HexabitzPlatform/H19R0x-Hardware/README.md

# H19R0x-Hardware
Hexabitz 38 V/10A Sensored BLDC Module Hardware Design
