HexabitzPlatform/H19R0x-Hardware/H19R00/Released/BOM/H19R00.xlsx

 |  | www.hexabitz.com info@hexabitz.com |  | Bill Of Materials
Customer | Hexabitz | Revision | 0
Project | Hexabitz Modules | Date | 2023-10-30
Board | 38 V/10A Sensored BLDC (H19R0) | Notes
Designator | Description | Manufacturer Part Number | Manufacturer | Octopart Url | Quantity
R | Headers & Wire Housings Unshrouded 1 POS T/H | 5-146280-1 | TE Connectivity | https://octopart.com/5-146280-1-te+connectivity+%2F+amp-40259676?r=sp | 1
SWD | Conn Unshrouded Header HDR 3 POS 2.54mm Solder ST Top Entry Thru-Hole Carton | 5-146281-3 | TE Connectivity | https://octopart.com/5-146281-3-te+connectivity+%2F+amp-39745942?r=sp | 1
J2 | TERM BLK 2POS SIDE ENTRY 5MM PCB | 691213710002 | Würth Elektronik | https://octopart.com/691213710002-wurth+elektronik-8917718?r=sp | 1
J1 | TERM BLK 3POS SIDE ENTRY 5MM PCB | 691213710003 | Wurth Elektronik | https://octopart.com/691213710003-wurth+elektronik-8917719?r=sp | 1
J4 | CONN HEADER SMD 6POS 1.27MM | 20021121-00006C1LF | Amphenol | https://octopart.com/20021121-00006c1lf-amphenol+communications+solutions-126547105?r=sp | 1
J3 | CONN HEADER SMD 8POS 1.27MM | 20021121-00008T4LF | Amphenol | https://octopart.com/20021121-00008t4lf-amphenol+communications+solutions-126517168?r=sp | 1
R1 , R52 | RES SMD 0.0OHM JUMPER 1/10W 0603 | RC0603JR-070RL | Yageo | https://octopart.com/rc0603jr-070rl-yageo-1241539?r=sp | 2
R10, R14, R17 | Current Sense Resistors - SMD 50 mOhms 1 W 50PPM/C 1 % 1206 | PE1206FRE470R05L | Yageo | https://octopart.com/pe1206fre470r05l-yageo-116359628?r=sp | 3
R4, R5, R11, R13, R15, R16 | RES 100 OHM 1% 1/10W 0603 | AC0603FR-13100RL | Yageo | https://octopart.com/ac0603fr-13100rl-yageo-74169481?r=sp | 6
R2, R53 | Thick Film Resistors - SMD 0603 270 Ohm 5% Tol | ERJ-3GEYJ271V | Panasonic | https://octopart.com/erj-3geyj271v-panasonic-55560546?r=sp | 2
R46, R48, R49 | Thick Film Resistors - SMD 0603 0.25W 1% 510ohm AEC-Q200 | ERJ-UP3F5100V | Panasonic | https://octopart.com/erj-up3f5100v-panasonic-108179035?r=sp | 3
R26, R28, R56 | RES 1K OHM 1% 1/10W 0603 | AC0603FR-131KL | Yageo | https://octopart.com/ac0603fr-131kl-yageo-73876229?r=sp | 3
R8, R18, R20, R40, R43, R45 | RES 2.4K OHM 1% 1/10W 0603 | RC0603FR-132K4L | Yageo | https://octopart.com/rc0603fr-132k4l-yageo-9297431?r=sp | 6
R9, R42, R44 | SMD Chip Resistor, 7.15 kOhm, ± 1%, 100 mW, 0603 | ERJ-3EKF7151V | Panasonic | https://octopart.com/erj-3ekf7151v-panasonic-55403668?r=sp | 3
R3, R55 | RES 10K Ohm 1% 0603 | RC0603FR-0710KL | Yageo | https://octopart.com/rc0603fr-0710kl-yageo-40025538?r=sp | 2
R24, R27, R29, R57 | RES 12K OHM 1% 1/10W 0603 | RC0603FR-0712KL | Yageo | https://octopart.com/rc0603fr-0712kl-yageo-55402881?r=sp | 4
R6, R7, R19, R21, R22, R41 | SMD Chip Resistor, 14.3 kOhm, ± 1%, 100 mW | ERJ-3EKF1432V | Panasonic | https://octopart.com/erj-3ekf1432v-panasonic-55421474?r=sp | 6
R25 | RES 100K OHM 1% 1/10W 0603 | RC0603FR-07100KL | Yageo | https://octopart.com/rc0603fr-07100kl-yageo-40946036?r=sp | 1
R54 | RES 180K OHM 1% 1/10W 0603 | RC0603FR-07180KL | Yageo | https://octopart.com/rc0603fr-07180kl-yageo-40952833?r=sp | 1
R47 | 200 kOhms ±1% 0.1W, 1/10W Chip Resistor 0603 | RC0603FR-07200KL | YAGEO | https://octopart.com/rc0603fr-07200kl-yageo-1190520?r=sp | 1
R12 | RES 750K OHM 1% 1/10W 0603 | RC0603FR-07750KL | Yageo | https://octopart.com/rc0603fr-07750kl-yageo-1227954?r=sp | 1
R23 | RES 2.4M OHM 1% 1/10W 0603 | RC0603FR-072M4L | Yageo | https://octopart.com/rc0603fr-072m4l-yageo-16255653?r=sp | 1
C14, C17, C18 | CAP CER 33PF 50V C0G/NP0 0603 | 0603N330J500CT | Walsin Technology Corporation | https://octopart.com/0603n330j500ct-walsin+technologies-23759704?r=sp | 3
C28, C29, C46 | CAP CER 220PF 50V X7R 0603 | 0603B221K500CT | Walsin Technology Corporation | https://octopart.com/0603b221k500ct-walsin+technologies-44320887?r=sp | 3
C19, C26, C27 | CAP CER 1000PF 50V C0G/NPO 0603 | CC0603KRNPO9BN102 | YAGEO | https://octopart.com/cc0603krnpo9bn102-yageo-65850404?r=sp | 3
C45 | CAP CER 0603 2.2NF 16V X7R 10% | C0603C222K4RECAUTO | KEMET | https://octopart.com/c0603c222k4recauto-kemet-91526488?r=sp | 1
C32, C33 | CAP CER 0603 10nF 100V X7R | C0603X103K1RAC3316 | KEMET | https://octopart.com/c0603x103k1rac3316-kemet-75810806?r=sp | 2
C1 ,C2, C4, C6, C21, C22, C23 | CAP CER 0.1 UF 10V 10% X7R 0603 | C0603C104K8RACTU | KEMET | https://octopart.com/c0603c104k8ractu-kemet-145075?r=sp | 7
C11, C15, C16 | CAP CER 0805 150NF 100V X7R | 08051C154KAT2A | KYOCERA AVX | https://octopart.com/08051c154kat2a-kyocera+avx-122049659?r=sp | 3
C8, C9, C10 | CAP CER 470nF 50V X5R 0603 | C1608X5R1H474K080AB | TDK Corporation | https://octopart.com/c1608x5r1h474k080ab-tdk-26013511?r=sp | 3
C5 | CAP CER 1 UF 16V X7R 0805 | CC0805KKX7R7BB105 | YAGEO | https://octopart.com/cc0805kkx7r7bb105-yageo-8376555?r=sp | 1
C24, C25 | CAP CER 1UF 50V X5R 0603 | UMK107BJ105KA-T | Taiyo Yuden | https://octopart.com/umk107bj105ka-t-taiyo+yuden-12090744?r=sp | 2
C7, C3 | CAP TANT 4.7 UF 10V 20% 0805 | 10TPU4R7MSI | Panasonic | https://octopart.com/10tpu4r7msi-panasonic-29487748?r=sp | 2
C12, C13 | CAP CER 10UF 50V X5R 0805 | GRM21BR61H106KE43K | Murata Electronics | https://octopart.com/grm21br61h106ke43k-murata-106705599?r=sp | 2
C20 | CAP CER 47UF 10V X5R 0805 | GRM21BR61A476ME15L | Murata Electronics | https://octopart.com/grm21br61a476me15l-murata-46693541?r=sp | 1
C30, C31 | Aluminum Electrolytic Capacitors - Radial Leaded 100uF 50V 85c | UVR1H101MPD1TD | Nichicon | https://octopart.com/uvr1h101mpd1td-nichicon-9292643?r=sp | 2
FB1 | Ind chip Bead Multi-Layer 30 ohms 25% 100MHZ Ferrite 1,5A 0603Punched paper T/R | MMZ1608Y300BTA00 | TDK | https://octopart.com/mmz1608y300bta00-tdk-7906990?r=sp | 1
FB2 | FIXED IND 22UH 220MA 1.25OHM SMD | MLZ2012P220WT000 | TDK Corporation | https://octopart.com/mlz2012p220wt000-tdk-34829284?r=sp | 1
D1, D10 | Red 0603 130° Clear 54 mcd 2 V Surface Mount ChipLED | VLMS1300-GS08 | Vishay | https://octopart.com/vlms1300-gs08-vishay-21709201?r=sp | 2
D2, D3, D4, D5, D6, D7 | Diode 30 V 300mA Surface Mount SOD-523 | BAT30KFILM | STMicroelectronics | https://octopart.com/bat30kfilm-stmicroelectronics-658191?r=sp | 6
D8 | Diode 100 V 200mA Surface Mount SOD-123 | MMSD4448 | onsemi | https://octopart.com/mmsd4448-onsemi-84330297?r=sp | 1
Q1, Q2, Q3 | 60V DUAL N-CHANNEL ENHANCEMENT M | PJQ5866A_R2_00001 | Panjit International Inc. | https://octopart.com/search?q=PJQ5866A_R2_00001&currency=USD&specs=0 | 3
U1 | MCU 32-Bit ARM Cortex-M0+ RISC 512kByte Flash 1.7V to 3.6V 48-Pin UFQFPN Tray | STM32G0B1CEU6N | STMicroelectronics | https://octopart.com/stm32g0b1ceu6n-stmicroelectronics-116364672?r=sp | 1
U2 | Advanced BLDC controller with embedded STM32 MCU | STSPIN32F0A | STMicroelectronics | https://octopart.com/stspin32f0a-stmicroelectronics-87213744?r=sp | 1
U3 | RS422RS485 interface transceiver 0/4 16VQFN | AM26LV32EIRGYR | Texas Instruments | https://octopart.com/am26lv32eirgyr-texas+instruments-12191980?r=sp | 1
U4 | LDO Regulator, 150 mA, 38 V, 1 uA IQ, with PG ADJ HZ, WDFN6 2x2 | NCP730BMTADJTBG | On Semi | https://octopart.com/ncp730bmtadjtbg-onsemi-106608704?r=sp | 1
X1 | 8,0000MHZ 33pF SMD MURATA Resonators | CSTNE8M00G550000R0 | Murata | https://octopart.com/cstne8m00g550000r0-murata-91406934?r=sp | 1
