HexabitzPlatform/H19R0x-Hardware/H19R00/Documentation/H19R00.pdf

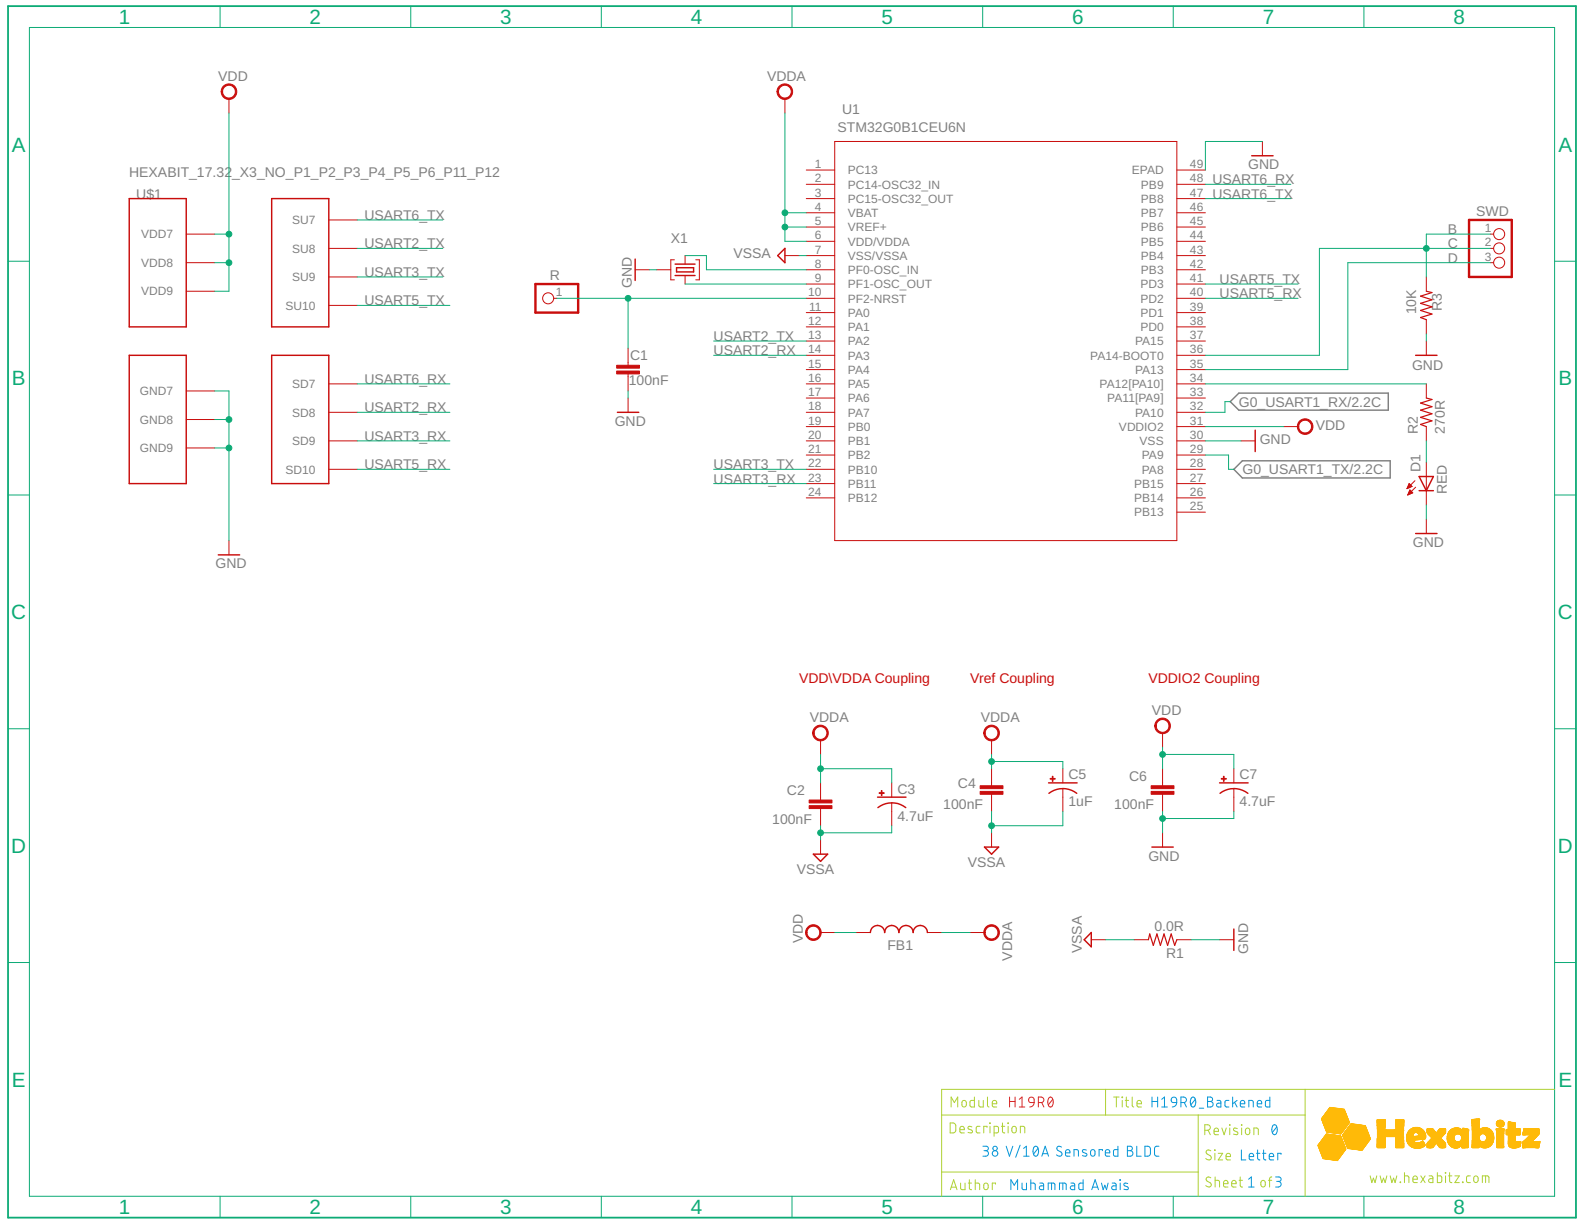
[picture p1: page 1]

VDDA

5 | | 45 PB7
6 | | 44 PB6

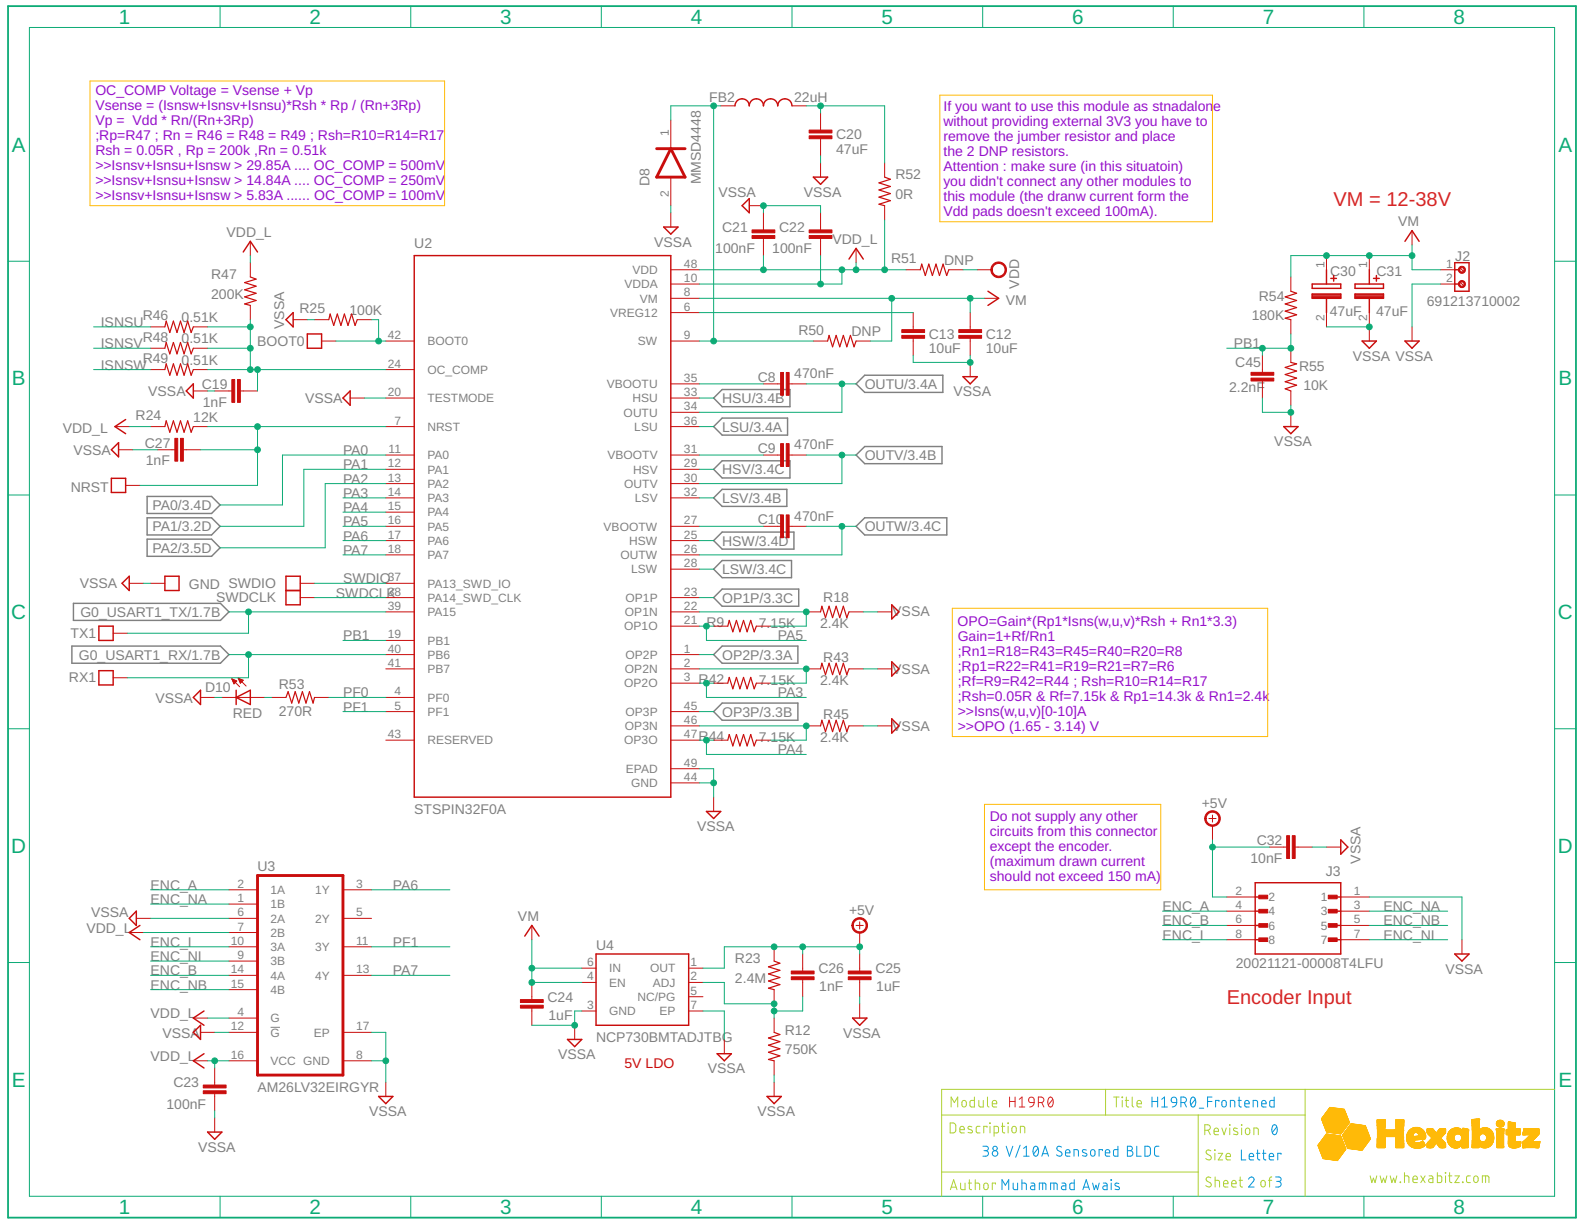
[picture p2: page 2]

OC_COMP Voltage = Vsense + Vp
Vsense = (Isnsw+Isnsv+Isnsu)*Rsh * Rp / (Rn+3Rp)
Vp = Vdd * Rn/(Rn+3Rp)
;Rp=R47 ; Rn = R46 = R48 = R49 ; Rsh=R10=R14=R17
Rsh = 0.05R , Rp = 200k ,Rn = 0.51k >>Isnsv+Isnsu+Isnsw > 29.85A .... OC_COMP = 500mV

If you want to use this module as stnadalone without providing external 3V3 you have to

remove the jumber resistor and place
the 2 DNP resistors. Attention : make sure (in this situatoin)

you didn't connect any other modules to
this module (the dranw current form the Vdd pads doesn't exceed 100mA).

8 VREG12

DNP

PA0 | 34 OUTV

PA2 | 31 VBOOTW
12 PA1 | HSV/3.4C

PA3 | 29 HSW 32

Do not supply any other circuits from this connector except the encoder. (maximum drawn current should not exceed 150 mA)

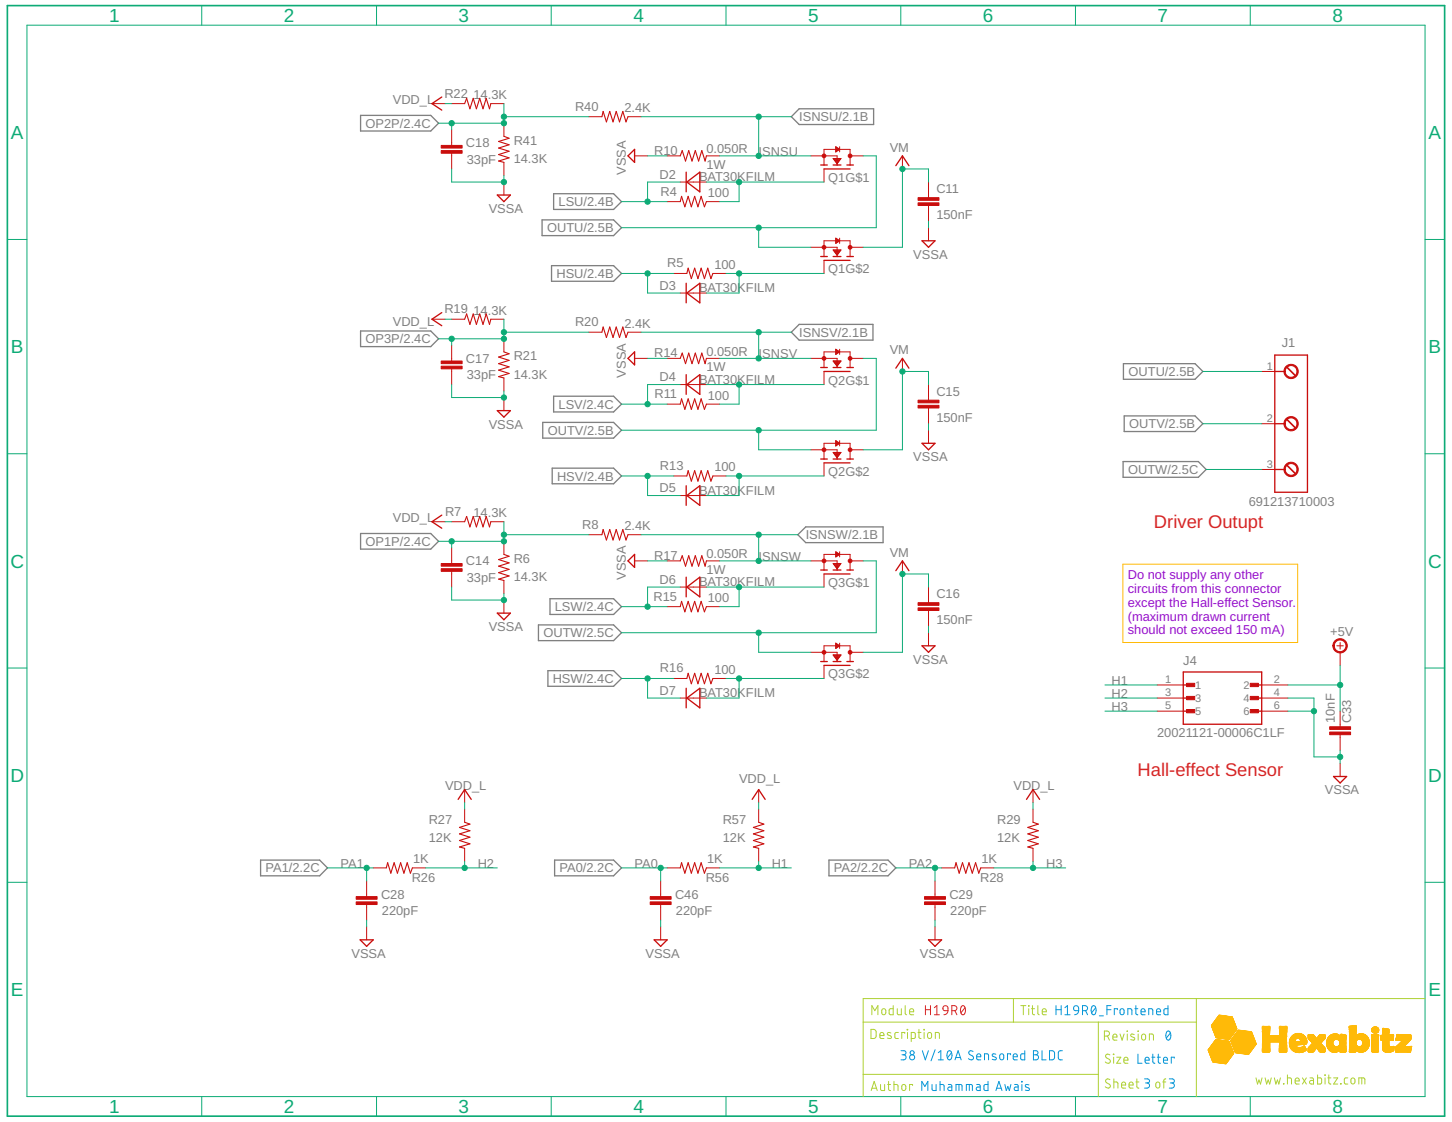
[picture p3: page 3]

Do not supply any other circuits from this connector except the Hall-effect Sensor. (maximum drawn current should not exceed 150 mA)
