HexabitzPlatform/H19R0x-Hardware/H19R00/Design/H19R00.brd

## EAGLE design H19R00/Design/H19R00.brd (2023-11-10)

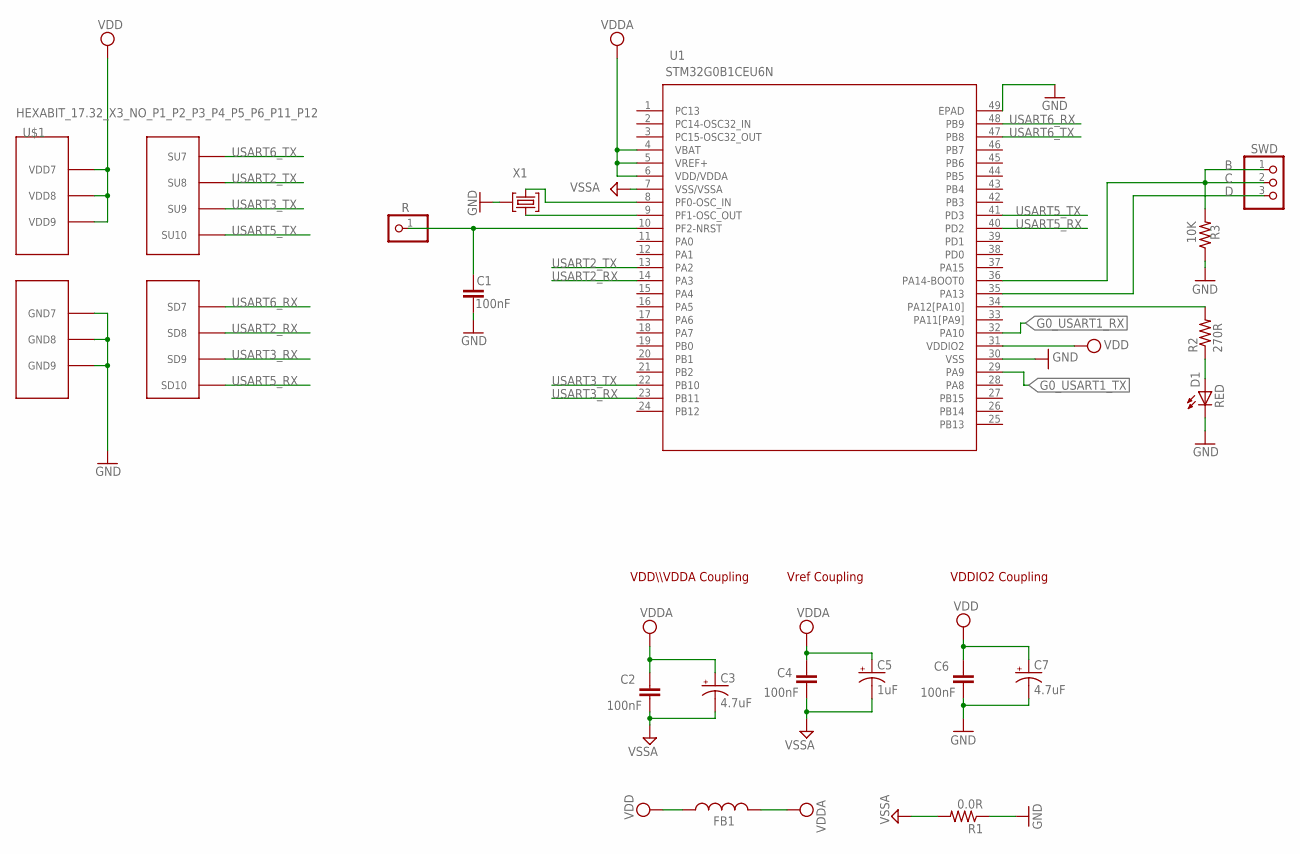
[picture p4: schematic H19R00.sch, sheet 1, I/O parts]

Parts:
C1: 100nF; C-0603; TOLERANCE 10%; VOLTAGE_RATING 16.0 V; MPN 0603YC104K4T2A
C2, C4, C6: 100nF; C-0603; TOLERANCE 10%; VOLTAGE_RATING 16.0 V; MPN '0603YC104K4T2A
C3: 4.7uF; C-0805-POL; TOLERANCE 20%; VOLTAGE_RATING 10.0 V; MPN '10TPU4R7MSI
C5: 1uF; C-0805-POL; TOLERANCE 20%; VOLTAGE_RATING 10.0 V; MPN 'CC0805KKX7R7BB105
C7: 4.7uF; C-0805-POL; TOLERANCE 10%; VOLTAGE_RATING 16.0 V; MPN '10TPU4R7MSI
D1: RED; VLMS1300-GS08
FB1: FB-TDK_MMZ1608Y300B; MPN MMZ1608Y300BTA00
R: PINHD-1X1; 1X01
R1: 0.0R; R-0603; MPN RC0603JR-070RL
R2: 270R; R-0603; MPN 'ERJ-3GEYJ271V
R3: 10K; R-0603; MPN '060300J0103T5E
SWD: PINHD-1X3; 1X03
U1: STM32G0B1CEU6N; HEXABITZ_ICS_QFN_B1CEU6_STM-L
U$1: HEXABIT_17.32_X3_NO_P1_P2_P3_P4_P5_P6_P11_P12
X1: 8MHZ; XTALL_CSTCE8M00G52; MPN CSTNE8M00G550000R0

Connections:
C: R3.2, SWD.1, SWD.2, U1.36 (PA14-BOOT0)
D: SWD.3, U1.35 (PA13)
G0_USART1_RX: U1.32 (PA10); also elsewhere on the board
G0_USART1_TX: U1.29 (PA9); also elsewhere on the board
GND: C1.1, C6.1, C7.2 (-), D1.C, R1.1, R3.1, U1.30 (VSS), U1.49 (EPAD), U$1.PAD_PD12 (GND7), U$1.PAD_PD17 (GND8), U$1.PAD_PD19 (GND9), X1.P$2 (2)
GND1: C2.1, C3.2 (-), C4.1, C5.2 (-), R1.2, U1.7 (VSS/VSSA); also elsewhere on the board
unnamed: U1.8 (PF0-OSC_IN), X1.P$1 (1)
unnamed: U1.9 (PF1-OSC_OUT), X1.P$3 (3)
unnamed: R2.2, U1.34 (PA12[PA10])
unnamed: D1.A, R2.1
unnamed: C1.2, R.1, U1.10 (PF2-NRST)
USART2_RX: U1.14 (PA3), U$1.PAD_PD1 (SD8)
USART2_TX: U1.13 (PA2), U$1.PAD_PU1 (SU8)
USART3_RX: U1.23 (PB11), U$1.PAD_PD2 (SD9)
USART3_TX: U1.22 (PB10), U$1.PAD_PU2 (SU9)
USART5_RX: U1.40 (PD2), U$1.PAD_PD8 (SD10)
USART5_TX: U1.41 (PD3), U$1.PAD_PU8 (SU10)
USART6_RX: U1.48 (PB9), U$1.PAD_PD3 (SD7)
USART6_TX: U1.47 (PB8), U$1.PAD_PU3 (SU7)
VDD: C6.2, C7.1 (+), FB1.1, U1.31 (VDDIO2), U$1.PAD_PU12 (VDD7), U$1.PAD_PU17 (VDD8), U$1.PAD_PU19 (VDD9); also elsewhere on the board
VDDA: C2.2, C3.1 (+), C4.2, C5.1 (+), FB1.2, U1.4 (VBAT), U1.5 (VREF+), U1.6 (VDD/VDDA)

Notes on the sheet:
VDDIO2 Coupling
VDD\\\VDDA Coupling
Vref Coupling

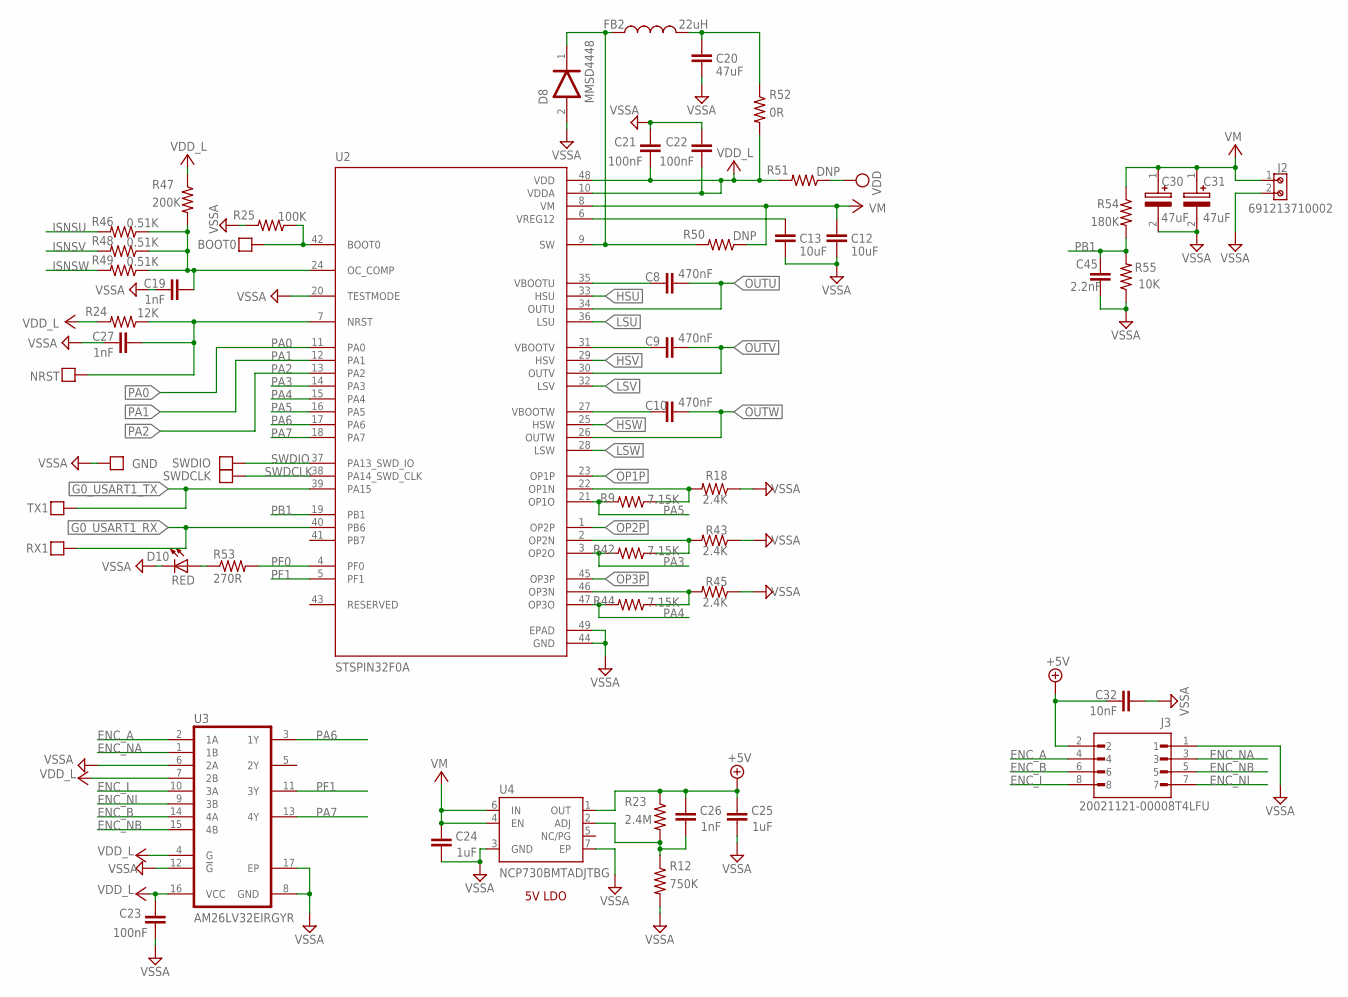
[picture p5: schematic H19R00.sch, sheet 2]

Parts:
BOOT0: PAD4
C8, C9, C10: 470nF; C-0603; TOLERANCE 10%; VOLTAGE_RATING 50V; MPN C1608X5R1H474K080AB
C12, C13: 10uF; C-0805; TOLERANCE 10%; VOLTAGE_RATING 50V; MPN GRM21BR61H106KE43K
C19, C26, C27: 1nF; C-0603; TOLERANCE 10%; VOLTAGE_RATING 50V; MPN CC0603KRNPO9BN102
C20: 47uF; C-0805; TOLERANCE 20%; VOLTAGE_RATING 10V; MPN GRM21BR61A476ME15K
C21, C22, C23: 100nF; C-0603; TOLERANCE 10%; VOLTAGE_RATING 16.0 V; MPN '0603YC104K4T2A
C24, C25: 1uF; C-0603; TOLERANCE 10%; VOLTAGE_RATING 50V; MPN UMK107BJ105KA-T
C30, C31: 47uF; CAPPRD350W60D825H1300
C32: 10nF; C-0603; TOLERANCE 10%; VOLTAGE_RATING 100V; MPN C0603X103K1RAC3316
C45: 2.2nF; C-0603; TOLERANCE 10%; VOLTAGE_RATING 16V; MPN C0603C222K4RECAUTO
D8: MMSD4448ONSEMI_MMSD4448_0_0; ONSEMI_MMSD4448_0
D10: RED; VLMS1300-GS08
FB2: 22uH; FB-0805; MPN MLZ2012P220WT000
GND: PAD4
J2: 691213710002
J3: 20021121-00008T4LFU; AMPHENOL_20021121-00008T4LF
NRST: PAD4
R9, R42, R44: 7.15K; R-0603; TOLERANCE 1%; MPN RC0603FR-0710K5L
R12: 750K; R-0603; TOLERANCE 1%; MPN RC0603FR-07750KL
R18, R43, R45: 2.4K; R-0603; TOLERANCE 1%; MPN RC0603FR-132K4L
R23: 2.4M; R-0603; TOLERANCE 1%; MPN RC0603FR-072M4L
R24: 12K; R-0603; TOLERANCE 1%; MPN RC0603FR-0712KL
R25: 100K; R-0603; TOLERANCE 1%; MPN RC0603FR-07100KL
R46, R48, R49: 0.51K; R-0603; TOLERANCE 1%; MPN RC0603FR-102K2L
R47: 200K; R-0603; TOLERANCE 1%; MPN RC0603FR-0718KL
R50, R51: DNP; R-0603; MPN DNP
R52: 0R; R-0603; TOLERANCE 1%; MPN RC0603FR-070RL
R53: 270R; R-0603; MPN 'ERJ-3GEYJ271V
R54: 180K; R-0603; TOLERANCE 1%; MPN RC0603FR-07180KL
R55: 10K; R-0603; MPN '060300J0103T5E
RX1: PAD4
SWDCLK: PAD4
SWDIO: PAD4
TX1: PAD4
U2: STSPIN32F0A; IC_STSPIN32F0A
U3: AM26LV32EIRGYRTEXAS_INSTRUMENTS_AM26LV32EIRGYR_0_0; TEXAS_INSTRUMENTS_AM26LV32EIRGYR_0
U4: NCP730BMTADJTBGON_SEMI_NCP730BMTADJTBG_0_0; ON_SEMI_NCP730BMTADJTBG_0

Connections:
+5V: C25.2, C26.2, C32.1, J3.2, R23.1, U4.1 (OUT); also elsewhere on the board
ENC_A: J3.4, U3.2 (1A)
ENC_B: J3.6, U3.14 (4A)
ENC_I: J3.8, U3.10 (3A)
ENC_NA: J3.3, U3.1 (1B)
ENC_NB: J3.5, U3.15 (4B)
ENC_NI: J3.7, U3.9 (3B)
G0_USART1_RX: RX1.P$1, U2.40 (PB6); also elsewhere on the board
G0_USART1_TX: TX1.P$1, U2.39 (PA15); also elsewhere on the board
GND1: C12.2, C13.2, C19.1, C20.2, C21.2, C22.2, C23.1, C24.1, C25.1, C27.1, C30.2 (-), C31.2 (-), C32.2, C45.1, D8.2 (ANODE), D10.C, GND.P$1, J2.2, J3.1, R12.2, R18.1, R25.2, R43.1, R45.1, R55.1, U2.20 (TESTMODE), U2.44 (GND), U2.49 (EPAD), U3.8 (GND), U3.12 (!G!), U3.17 (EP), U4.3 (GND), U4.7 (EP); also elsewhere on the board
HSU: U2.33 (HSU); also elsewhere on the board
HSV: U2.29 (HSV); also elsewhere on the board
HSW: U2.25 (HSW); also elsewhere on the board
ISNSU: R46.2; also elsewhere on the board
ISNSV: R48.2; also elsewhere on the board
ISNSW: R49.2; also elsewhere on the board
LSU: U2.36 (LSU); also elsewhere on the board
LSV: U2.32 (LSV); also elsewhere on the board
LSW: U2.28 (LSW); also elsewhere on the board
unnamed: R42.1, R43.2, U2.2 (OP2N)
unnamed: C8.2, U2.35 (VBOOTU)
unnamed: C9.2, U2.31 (VBOOTV)
unnamed: C10.2, U2.27 (VBOOTW)
unnamed: C26.1, R12.1, R23.2, U4.2 (ADJ)
unnamed: C27.2, NRST.P$1, R24.1, U2.7 (NRST)
unnamed: C13.1, U2.6 (VREG12)
unnamed: BOOT0.P$1, R25.1, U2.42 (BOOT0)
unnamed: R9.1, R18.2, U2.22 (OP1N)
unnamed: R44.1, R45.2, U2.46 (OP3N)
unnamed: C19.2, R46.1, R47.2, R48.1, R49.1, U2.24 (OC_COMP)
unnamed: D10.A, R53.1
unnamed: D8.1 (CATHODE), FB2.1, R50.2, U2.9 (SW)
unnamed: C20.1, FB2.2, R52.1
OP1P: U2.23 (OP1P); also elsewhere on the board
OP2P: U2.1 (OP2P); also elsewhere on the board
OP3P: U2.45 (OP3P); also elsewhere on the board
OUTU: C8.1, U2.34 (OUTU); also elsewhere on the board
OUTV: C9.1, U2.30 (OUTV); also elsewhere on the board
OUTW: C10.1, U2.26 (OUTW); also elsewhere on the board
PA0: U2.11 (PA0); also elsewhere on the board
PA1: U2.12 (PA1); also elsewhere on the board
PA2: U2.13 (PA2); also elsewhere on the board
PA3: R42.2, U2.3 (OP2O), U2.14 (PA3)
PA4: R44.2, U2.15 (PA4), U2.47 (OP3O)
PA5: R9.2, U2.16 (PA5), U2.21 (OP1O)
PA6: U2.17 (PA6), U3.3 (1Y)
PA7: U2.18 (PA7), U3.13 (4Y)
PB1: C45.2, R54.2, R55.2, U2.19 (PB1)
PF0: R53.2, U2.4 (PF0)
PF1: U2.5 (PF1), U3.11 (3Y)
SWDCLK: SWDCLK.P$1, U2.38 (PA14_SWD_CLK)
SWDIO: SWDIO.P$1, U2.37 (PA13_SWD_IO)
VDD: R51.1; also elsewhere on the board
VDD_L: C21.1, C22.1, C23.2, R24.2, R47.1, R51.2, R52.2, U2.10 (VDDA), U2.48 (VDD), U3.4 (G), U3.7 (2B), U3.16 (VCC); also elsewhere on the board
VM: C12.1, C24.2, C30.1 (+), C31.1 (+), J2.1, R50.1, R54.1, U2.8 (VM), U4.4 (EN), U4.6 (IN); also elsewhere on the board

Notes on the sheet:
5V LDO

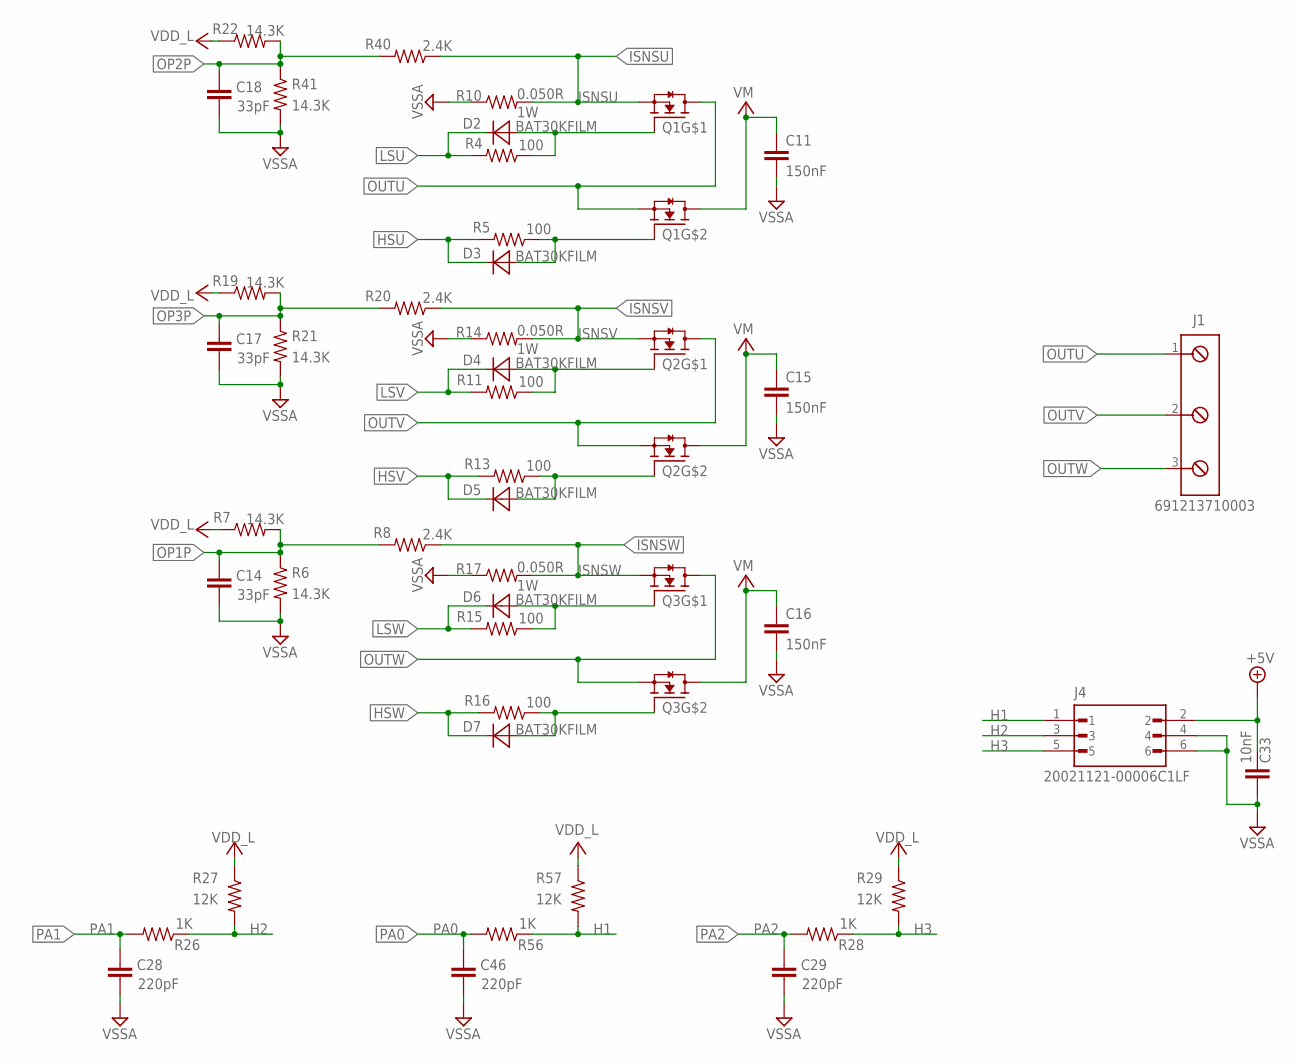
[picture p6: schematic H19R00.sch, sheet 3]

Parts:
C11, C15, C16: 150nF; C-0805; TOLERANCE 10%; VOLTAGE_RATING 100V; MPN C0805C154K1REC7800
C14, C17, C18: 33pF; C-0603; TOLERANCE 10%; VOLTAGE_RATING 50V; MPN 0603N330J500CT
C28, C29, C46: 220pF; C-0603; TOLERANCE 10%; VOLTAGE_RATING 50V; MPN 0603B221K500CT
C33: 10nF; C-0603; TOLERANCE 10%; VOLTAGE_RATING 100V; MPN C0603X103K1RAC3316
D2, D3, D4, D5, D6, D7: BAT30KFILM; STMICROELECTRONICS_BAT30KFILM_0
J1: 691213710003
J4: 20021121-00006C1LF; AMPHENOL_20021121-00006C1LF
Q1, Q2, Q3: PJQ5866A_R2_00001; PJQ5866A_R2_00001-8-POWERTDFN
R4, R5, R11, R13, R15, R16: 100; R-0603; TOLERANCE 1%; MPN AC0603FR-13100RL
R6, R7, R19, R21, R22, R41: 14.3K; R-0603; TOLERANCE 1%; MPN RC0603FR-0721KL
R8, R20, R40: 2.4K; R-0603; TOLERANCE 1%; MPN RC0603FR-132K4L
R10, R14, R17: 0.050R; R1206; TOLERANCE 1%; MPN ERJ-8BWFR100V
R26, R28, R56: 1K; R-0603; TOLERANCE 1%; MPN AC0603FR-131KL
R27, R29, R57: 12K; R-0603; TOLERANCE 1%; MPN RC0603FR-0712KL

Connections:
+5V: C33.1, J4.2; also elsewhere on the board
GND1: C11.2, C14.1, C15.2, C16.2, C17.1, C18.1, C28.1, C29.1, C33.2, C46.1, J4.4, J4.6, R6.2, R10.1, R14.1, R17.1, R21.2, R41.2; also elsewhere on the board
H1: J4.1, R56.1, R57.2
H2: J4.3, R26.1, R27.2
H3: J4.5, R28.1, R29.2
HSU: D3.C, R5.2; also elsewhere on the board
HSV: D5.C, R13.2; also elsewhere on the board
HSW: D7.C, R16.2; also elsewhere on the board
ISNSU: Q1.1 (S1), R10.2, R40.1; also elsewhere on the board
ISNSV: Q2.1 (S1), R14.2, R20.1; also elsewhere on the board
ISNSW: Q3.1 (S1), R8.1, R17.2; also elsewhere on the board
LSU: D2.C, R4.2; also elsewhere on the board
LSV: D4.C, R11.2; also elsewhere on the board
LSW: D6.C, R15.2; also elsewhere on the board
unnamed: D2.A, Q1.2 (G1), R4.1
unnamed: D4.A, Q2.2 (G1), R11.1
unnamed: D3.A, Q1.4 (G2), R5.1
unnamed: D5.A, Q2.4 (G2), R13.1
unnamed: D6.A, Q3.2 (G1), R15.1
unnamed: D7.A, Q3.4 (G2), R16.1
OP1P: C14.2, R6.1, R7.2, R8.2; also elsewhere on the board
OP2P: C18.2, R22.2, R40.2, R41.1; also elsewhere on the board
OP3P: C17.2, R19.2, R20.2, R21.1; also elsewhere on the board
OUTU: J1.1, Q1.3 (S2), Q1.7_8 (D1); also elsewhere on the board
OUTV: J1.2, Q2.3 (S2), Q2.7_8 (D1); also elsewhere on the board
OUTW: J1.3, Q3.3 (S2), Q3.7_8 (D1); also elsewhere on the board
PA0: C46.2, R56.2; also elsewhere on the board
PA1: C28.2, R26.2; also elsewhere on the board
PA2: C29.2, R28.2; also elsewhere on the board
VDD_L: R7.1, R19.1, R22.1, R27.1, R29.1, R57.1; also elsewhere on the board
VM: C11.1, C15.1, C16.1, Q1.5_6 (D2), Q2.5_6 (D2), Q3.5_6 (D2); also elsewhere on the board

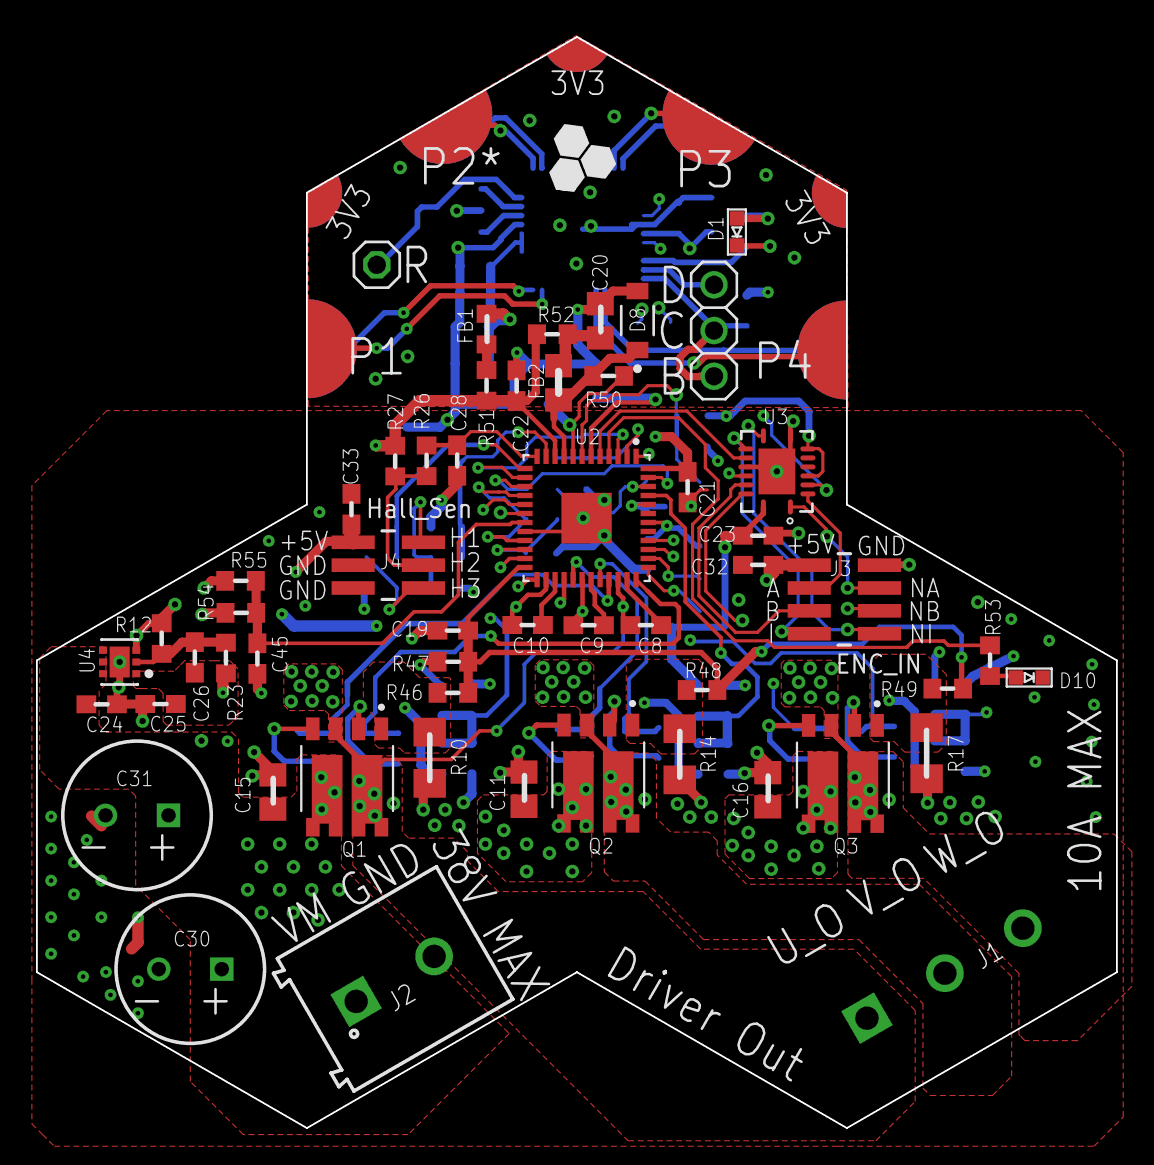
[picture p7: board H19R00.brd from above]

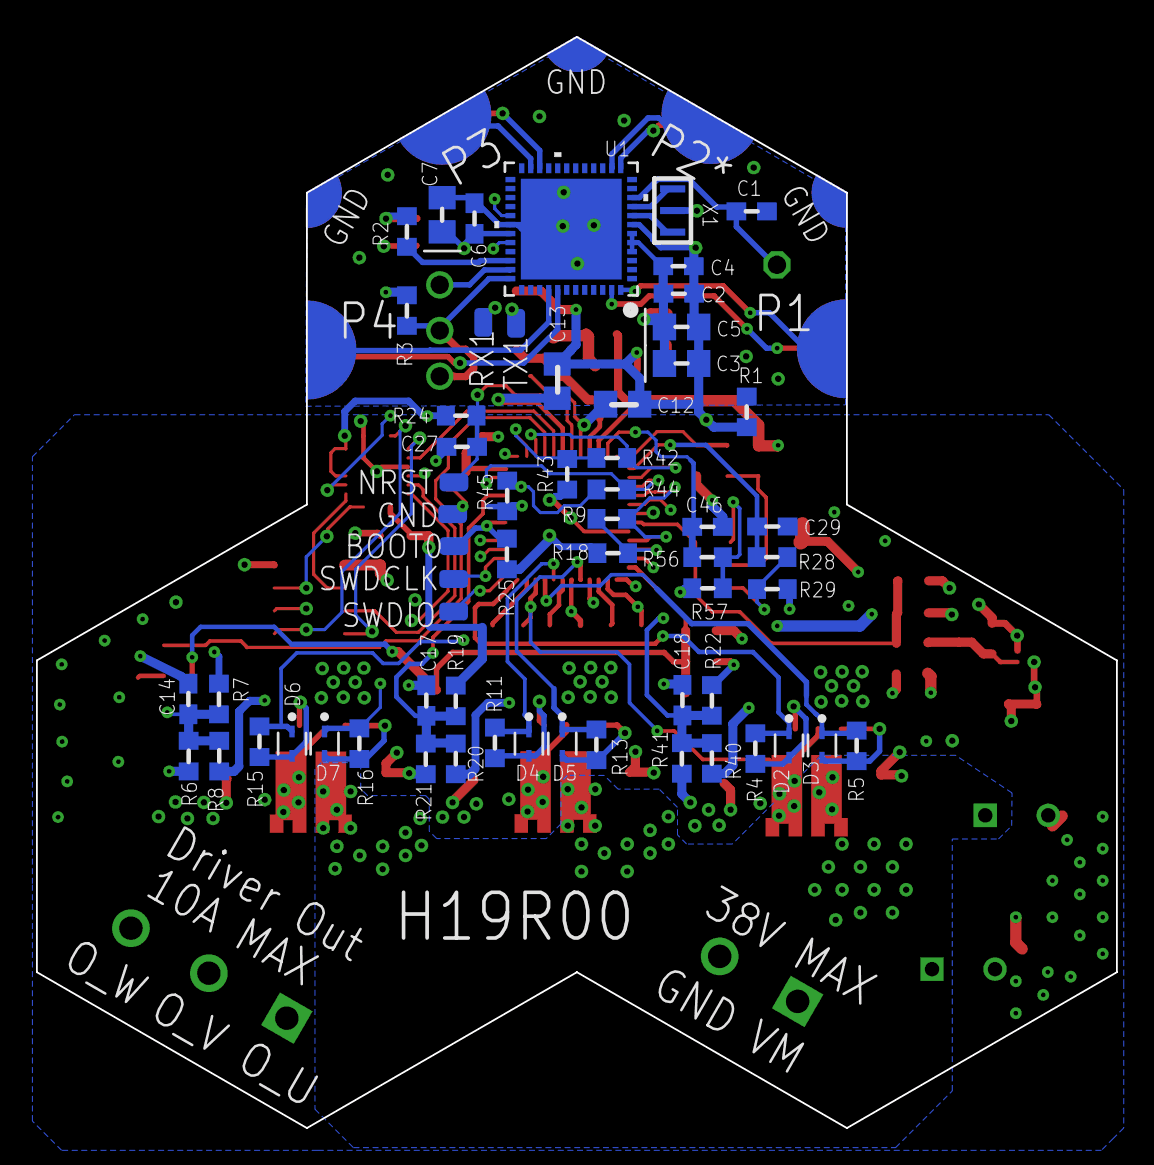
[picture p8: board H19R00.brd from below]

Board: 4 copper layers, 60.0 x 60.6 mm, 115 parts (60 on the bottom side), 81 nets.
