HexabitzPlatform/H19R0x-Hardware/(commit log)

2023-06-14 -Create the Back-end design
    [H19R00.brd, H19R00.sch]
2023-06-15 -Add the logo and the module name to the layout
    [H19R00.brd]
2023-10-10 -Adding the Original Files that has been designed by the Designer
    [H19R00 BOM.xlsx, H19R00.brd, H19R00.sch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]
2023-10-11 -Add some notes to the schematic -fix the BOM - Add NRST,TX1 and RX1 test points -Fix some issues at the silkscreen layer
    [H19R00 BOM.xlsx, H19R00.brd, H19R00.sch, H19R00.xlsx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]
2023-10-11 -Fix the BOM and some parts attributes
    [H19R00.brd, H19R00.sch, H19R00.xlsx]
2023-10-12 -Fix the BOM
    [H19R00.xlsx]
2023-11-05 -Before editing the layout
    [H19R00.brd, H19R00.sch, H19R00.xlsx]
2023-11-10 All the edits that is related to 10A handling is done : -Improve the layout design so the pcb can handle continous current up to 10A -Naming the smd pin headers and thier pins on the silk screen laye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
    [H19R00.brd, H19R00.sch, H19R00.xlsx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]
